Suprathik53/ece445-lab-notebook/notebooks/prineet/README.md

# Prineet Worklog

[[_TOC_]]

# 2026-02-13 - Meeting Zhuchen & Project Proposal

This week marked our first meeting with our group TA, Zhuchen Shao. We told him the idea we had for our project and presented our initial block diagram. This was helpful for both him and us, since in building out our high-level block diagram we were able to better clarify to each other in the group what exactly we meant when we were pitching our idea to each other. 

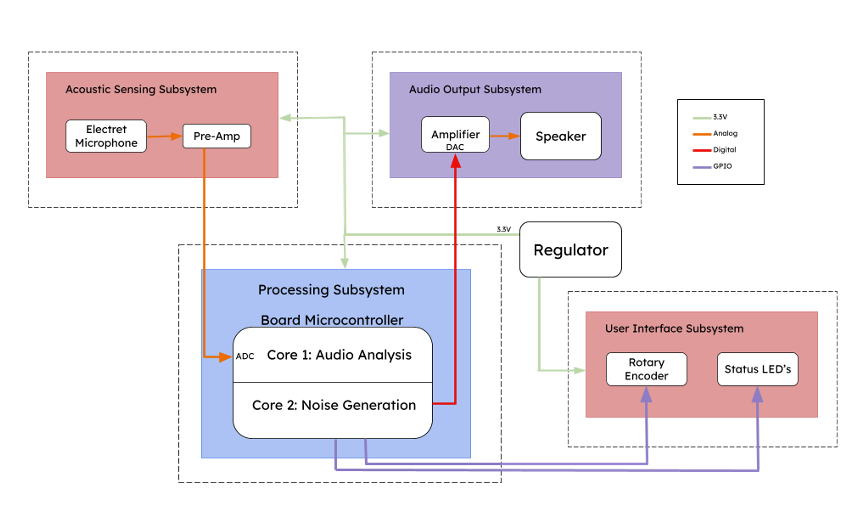
[picture p1: notebooks/prineet/block_diagram.png]


He showed us how we can order our parts in the future and helped us understand more about what was expected of us. I also thought about the PCB and started to draw up plans for what we would want on it when that time would come.

# 2026-02-20 - PCB Schematic is Done

This week, I really worked on hard on making the PCB schematic for the project. I really wanted to make the early deadline of 2/20 to have our PCB reviewed by a TA. I also heard that extra credit was given to teams that were able to do that, but I wasn't able to make the deadline for that. That's ok though, since Supra and Srikar are starting to compile the order list that they want to give to Zhuchen for our first big order of parts. Since I worked on the Schematic, I'll probably let Supra and Srikar take care of the actual layout while I take over for them for ordering the parts and getting ready for our first big lab session. 

I was able to present my schematic to Zhuchen to our group meeting, he seemed impressed and offered me good feedback on what I had done.

This was the processing unit I designed:

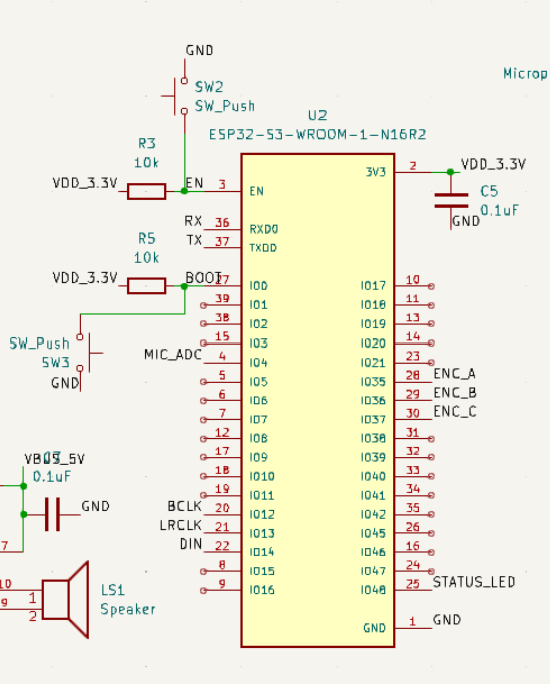
[picture p2: notebooks/prineet/processing_schematic.png]


Here's the microphone/input system:

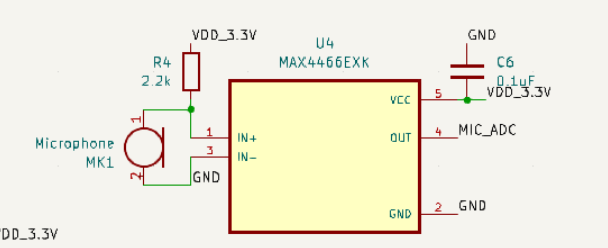
[picture p3: notebooks/prineet/mic_schematic.png]


Finally, here's the speaker schematic:

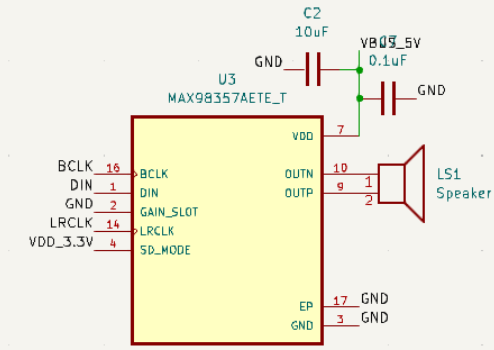
[picture p4: notebooks/prineet/speaker_schematic.png]


# 2026-02-27 - The PCB is Finished

Our group decided to make a couple of core changes to our design. Firstly, we changed to using the Alps Switch encoder for our design. We also changed how we power our whole system. We used to do it with USB-C, that's what I put in the schematic. Howewver, we changed to Micro USB, as it should be easier for us to use and power. The tradeoff with this is that obtaining a Micro USB cable is harder, I know I certainly don't have one. 

Srikar also worked hard this week on the PCB layout. He took the PCB schematic that I made last week, made the proper tweaks to change what I outlined above, and then made the layout for the PCB. 

Here is the finalized PCB layout:

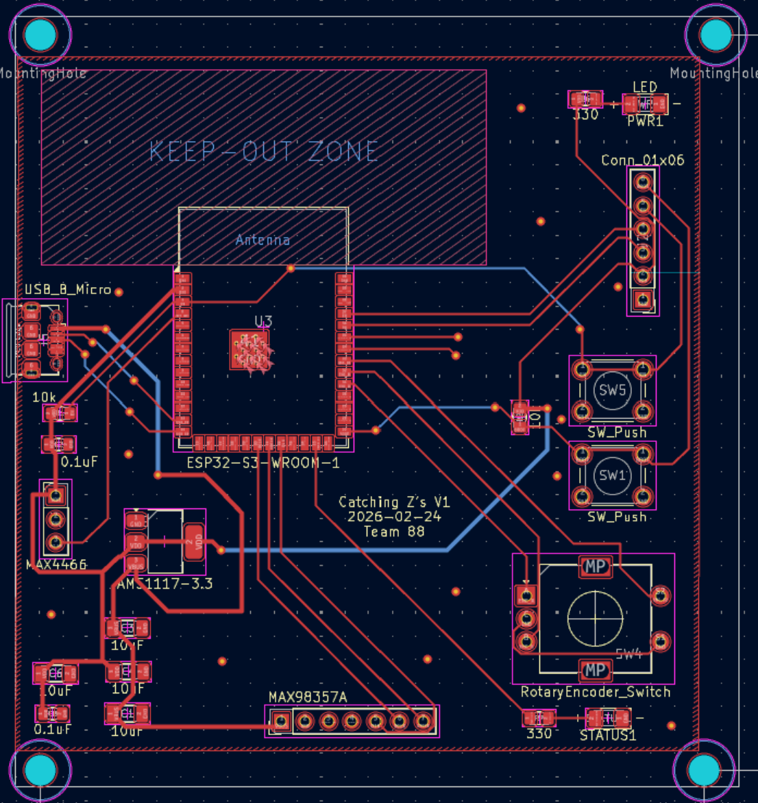
[picture p5: notebooks/prineet/pcb_layout.png]


Me and Supra also worked on updating our order list to account for the changes that we had made to what we need for our PCB. 

I like the current pace of our project. Because we're doing a good job of keeping each other updated, it's made it easier on all of us as it lessens the tension that is associated with having partners during a group project.

Additionally, our design doc was due today. A lot of what we want to accomoplish is in the design doc. I'll attach the relevant portions here.

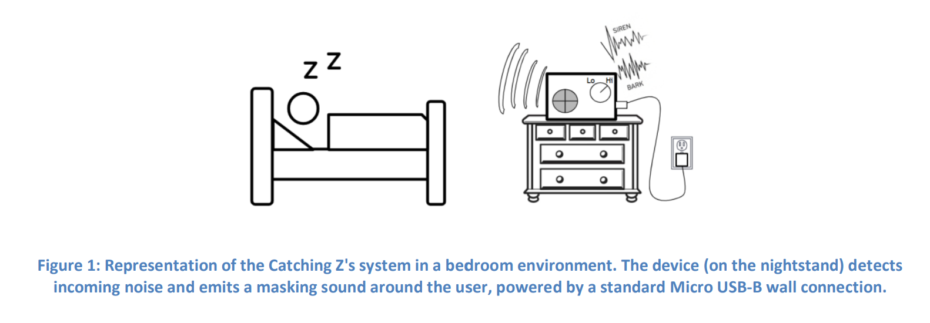
[picture p6: notebooks/prineet/design_doc_1.png]


To trigger a masking noise, the noise event should be at least 10 dB higher than the baseline. So, the amplitude ratio can be found by:

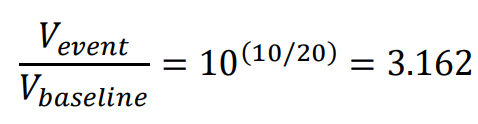
[picture p7: notebooks/prineet/amplitude_ratio.png]


This is what we've estimated our project to cost (this is pretty interesting to me, I wonder how much it would be if we bought the components for this project wholesale, like if we were doing mass manufacturing for this system).

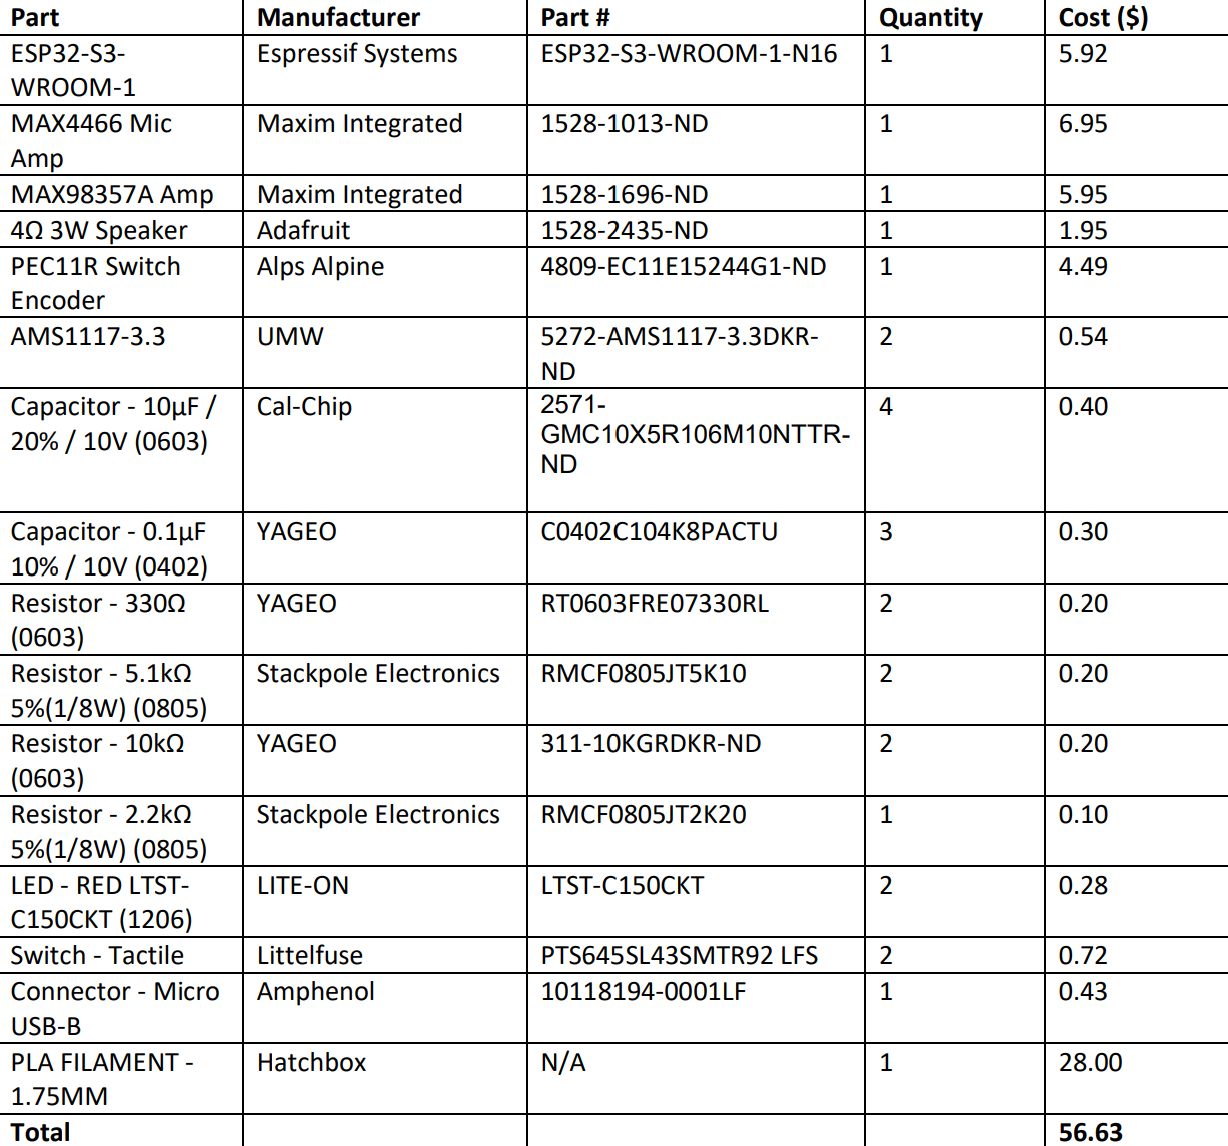
[picture p8: notebooks/prineet/projected_costs.png]


# 2026-03-06 - Prototyping

During our design review with Professor Gruev, he suggested that we make our project more complicated. His main point here is that we were not doing anything novel, which is a fair criticism of our project. We should aim higher, and I believe in our group enough to accomplish it. One of the things that he mentioned was to add spectral analysis to our project. 

With this spectral analysis, we might be able to have the output frequency match the input frequency, allowing for the ability to mask different kind of noises adaptively to what is happening in the background.  

We also started to work on our breadboard. We had to use the ESP32 dev board since our STM32 one didn't work. We added a microphone to get input and a LED array to act as like a volume display to show how loud the input sound was. 

I hope that this is enough progress for our breadboard demo next week. It has been difficult for us since we are still waiting to get some components to start actual dev work, so we had to do the best we could with what we had. I think that what we have right now is sufficient to show that we have a plan with the input audio that comes through the microphone.

# 2026-03-13 - Last Day Before Spring Break

We found some breakout boards that we got permission to use on the final project. This would make the layout of the PCB so much cleaner and smaller, so it was a no brainer for us to use it. Here are the two breakout boards that we found:

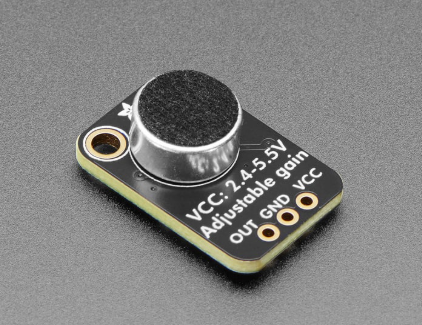
[picture p9: notebooks/prineet/breakout_1.png]


Link: https://www.adafruit.com/product/1063?srsltid=AfmBOoq1_ZeF1upSoV16VT7XkKl8Ah0HNs23jcOlRoFMnywjewPwBUsj 

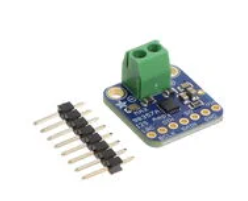
[picture p10: notebooks/prineet/breakout_2.png]


Link: https://www.digikey.com/en/products/detail/adafruit-industries-llc/3006/6058477

We had to update our PCB layout to accomodate for this change. Here is the updated layout:

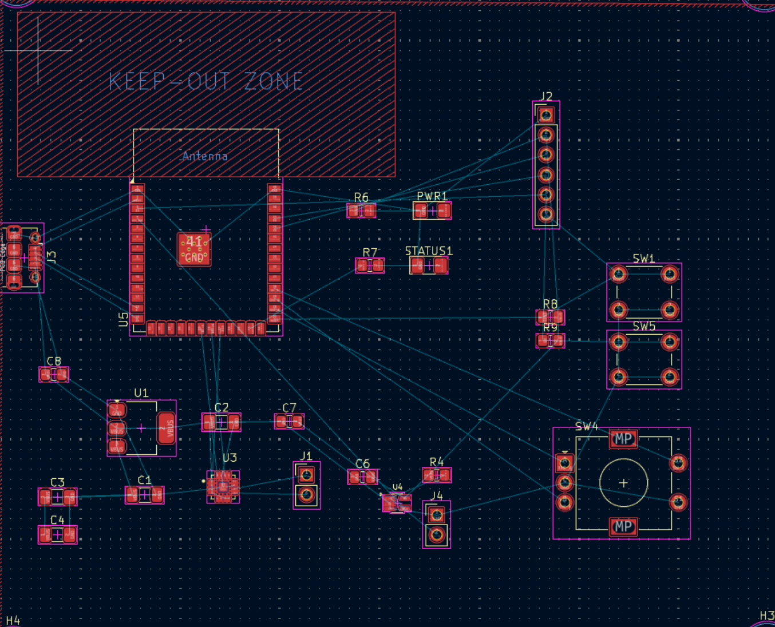
[picture p11: notebooks/prineet/updated_layout.png]


This is what the current state of the breadboard is, with our current hardware on it for the input noise volume sensing:

For our breadboard demo, we were able to integrate the adaptive baseline code. First, the room volume is sampled 100 times, which corresponds to 20 ms. For the final system, we will probably have it sample for a couple of seconds to establish a fimer and prolonged baseline. The current room noise was also sampled as we moved, slowly getting faded into the baseline according to how we tuned an adaptive baseline constant, which we can call alpha. If alpha is high, the current room value plays a big part in updating the moving baseline. If it is low, the change to the moving baseline is more subtle.

The LED is there to simulate the speaker. When the LED turns on, it is as if the threshold has been crossed (which we know due to the tolerance analysis which I included above) and the speaker (in this case, the LED) should be turned on. 

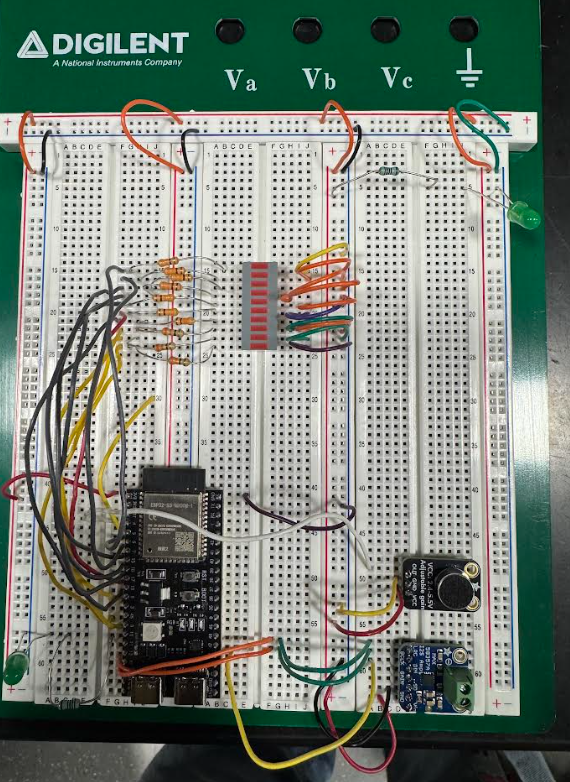
[picture p12: notebooks/prineet/breadboard_demo.png]


# 2026-03-27 - PCB Debugging and Enclosure

We attempted to use our PCB this week. It had its fair share of ups and downs I can talk about. For some reason, when we initially tried to use our PCB the first time, nothing was working. We tried debugging everything, but we couldn't figure out why we couldn't load any code onto the PCB. We even took a knife and cut the PCB down to its traces to make sure that everything was inline with what we thought was going on. We gave up. However, the next day, when we tried a different PCB, everything worked. We were able to solder everything onto that PCB and have the code load into the PCB with no problem. We must have shorted something on the first PCB by soldering incorrectly.

We also submitted a new PCB design that made debugging a little easier, since it was so hard to see what was going wrong on the first PCB that we were using.

Supra also started to design the enclosure in CAD. This would be a 3D model that had mounts for the PCB at the base of the enclosure, the speaker, microphone, and encoder mount. This is the enclosure prototype that Supra came up with:

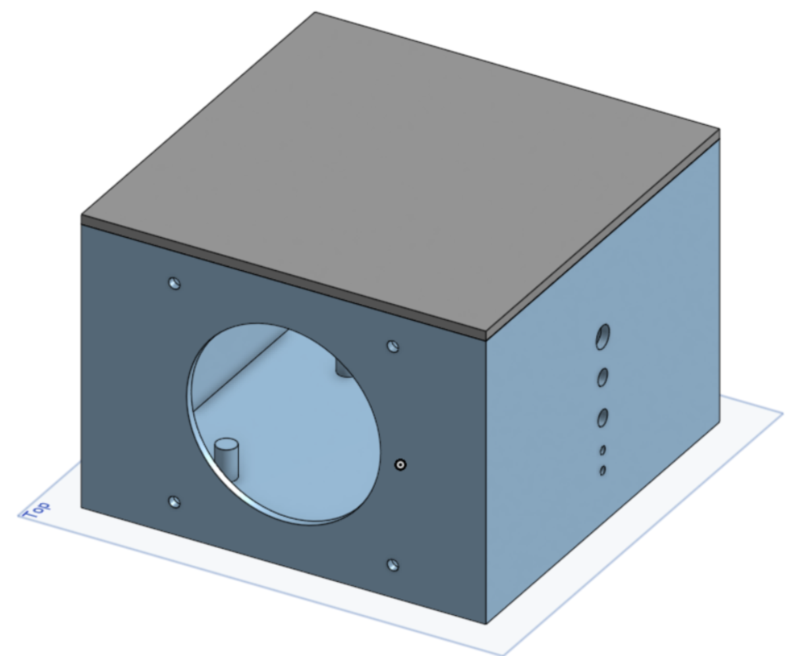
[picture p13: notebooks/prineet/enclosure_1.png]


We also receieved our speakers, so we were able to connnect them to our breadboard and test some code that generated white noise instead of lighting up the LED. That worked, so it was a good sign that we had a good baseline to start from.



# 2026-04-03 - PCB Soldering

We continued to solder the components that we had onto the PCB board, incrementally testing the components that we had soldered with both software and through the oscilloscope. We also transferred the code over from the breadboard to the PCB.

# 2026-04-10 - Coding!

This past week was all about getting as far as we could with the code. The specs that we had in our design doc specified that we would use the two cores that our microcontroller had, one to do input processing and the other to generate the noise. Up till this point, everything had been happening on one core. So, we switched our code to fully utilizing the two different cores. This actually solved an issue we were having, which was with choppy audio. By splitting up the hard work between two cores, each core was able to focus more on doing a better job for the task it was assigned to.

We also added the baseline in for spectral analysis. We did this so that the speaker would play either white, brown, or pink noise depending on what the input frequency was. The output sound fades in and fades out to not create sharp lines that can impact the sleep of the user.

We also did more complex signal analysis on the output besides the spectral analysis. We added a low pass filter to the signal to cut off the errors and reduce any high frequency noise that is not necessary. 

The enclosure also finished printing before our progress demo with Professor Gruev, and we were able to test in the enclosure. We were running into a lot of trouble after putting our system in the enclosure, however, since the microphone and speaker were creating an infinite feedback loop where the speaker output was triggering the microphone input. However, by adding some tissue paper inside the enclosure to act as a dampener, we were able to put a band aid on the problem. In the future, we will need to purchase or find some high quality foam, like the kind that is used in recording studios to block out other noise, and install that along the walls and inside above the PCB and by the inner walls of the speaker and microphone.

# 2026-04-17 - Results + How We Can Make it Better

We have been seeing promising results with everything thusfar. We wanted to expand the directionality that the speakers had so the system could be in different positions and still hit the user as they were speaker. So, we redesigned the system to have two speakers, each outputting the same noise. In order to do this in the hardware, we would change the enclosure to be a pentagon, putting the speakers and microphone on opposite ends to minimize the chance they start an infinite feedback loop. 

During early testing, we found that bucket based spectral analysis did not provide enough variation to generate masking noise that worked well. Because of this, I revised the code so that it reads a 128-sample microphone frame at a 16 kHz sampling rate, subtracts the DC component, calculates loudness-related values, and passes the frame into an analysis routine.

Inside that analysis routine, the signal is first multiplied by a Hann window and then processed with an FFT. For each bin, the magnitude is smoothed across time, and nearby bins are combined to estimate the local energy around that frequency. From there, the program identifies the largest peak and the next-largest peak.

This directly goes into choosing the type of masking sound that we are generating. The program asks whether the frame is loud enough to matter and whether that peak is stronger than the old and secondary peak. If all of these conditions are met, the system will playh the new masking noise to match what it's hearing.

# 2026-04-24 - New Enclosure

The new enclosure finished printing. We trasnferred what we had over to the new enclosure, and using some bolts and nuts that I got from going down to the ECE mechanic shop and trying a bunch of different sized bolts and nuts from different drawers, secured everything in place.

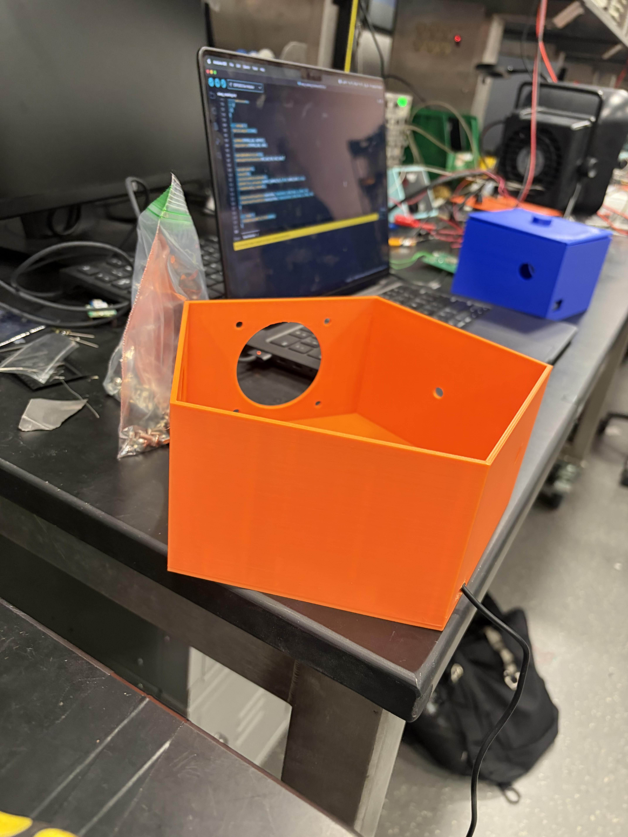
[picture p14: notebooks/prineet/both_enclosures.png]


We also connected the additional speaker by splitting the output wires to the speaker in two, with each set going to a speaker.



After switching to the two speaker approach, we saw that the audio output was extremely choppy. This had something to do with the fact that we had not really tuned our constants for two speakers, so we had to go back to the testing table and continually test our noise until it got better, but the choppiness never really went away. 

We realized that we would have to change to using a lazy buffer. Currently, the processing that we were doing was preventing the ESP from populating the speaker's output buffer at a fast enough rate. So, if we add each generated value to the output buffer more than once, the speaker's output buffer might be able to keep up with the input. This ended up working beautifully.

# 2026-05-01 - Satisfying the Verifications and Python Simulations

Before we were able to get started on the verifications, we had to add the foam into the inside of the enclosure as we said we would to mitigate a feedback loop. We also added another microphone on the inside of the enclosure to subtract what the inside microphone heard from what the speakers were playing to tell the system to not look at that frequency as a potential input. These two fixes worked in tandem to prvent the feedback loop from happening again.

We had to satisfy all the constraints that we set for ourselves when we initially took on this challenge. The most important test was verifying that the system would work overnight (~8 hours) without overheating or breaking. We set the system up overnight and let it work, uninterrupted, while Srikar slept. Here are the logs:

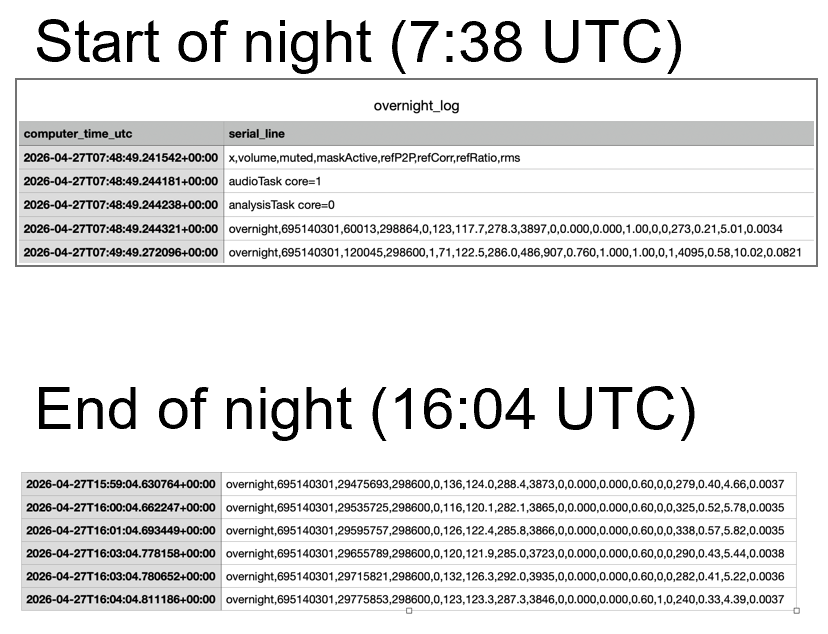
[picture p16: notebooks/prineet/logs.png]


Before our simulations, we could only state qualitatively that by putting your head by the speaker and pretending like you were sleeping, the system would mask the noise that was being played into the microphone. However, the simulation below shows a cool visualization proving the effectiveness of the system.

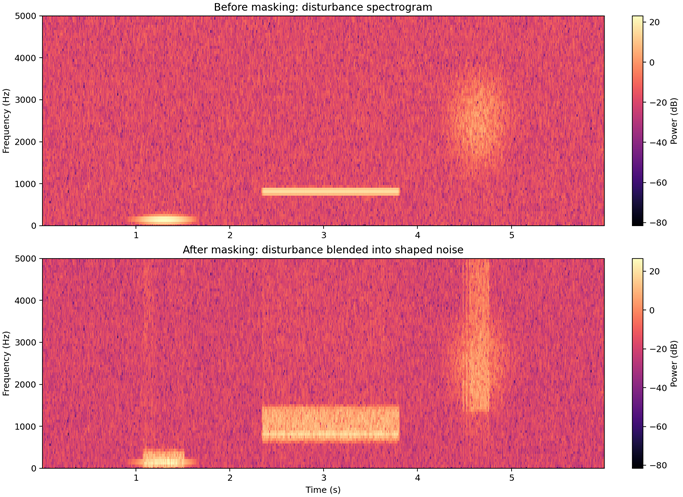
[picture p17: notebooks/prineet/graph.png]


The top plot shows a noise events impact on the event without the noise masking provided by our system. As you can see, the lines are clearly separable, showing a big impact on the user's sleep. The bottom graph, on the other hand, shows what happens when the system is on. The lines are blurred, as the device causes any input noises to fade into the background, severly decreasing the chance that a noise event would disrupt the user's sleep.
