Suprathik53/ece445-lab-notebook/notebooks/suprathik/README.md

# Suprathik Worklog

[[_TOC_]]

# 2026-02-13 - Discussion with TA Zhuchen Shao

This week we first met with our group TA to discuss the overall direction of our project. After building a visual understanding of how the project's subsystems would come together through a block diagram we then finalized logistics on how parts would be ordered and future meeting times and expectations. Later in the week I worked on finalizing the proposal including further ideating on the form factor of the product and deciding the exact sensors and parts we would be using. 



# 2026-02-20 - Schematic Design and Parts Updates

To start this week, our group began developing the schematic for our PCB in KiCad and successfully laid out the components for review during our mentor meeting. After planning part of the PCB design, I worked on preparing an order form for the parts available from the E-Shop.



However, some changes arose while selecting footprints for the schematic components and discussing the rotary encoder we planned to use. We considered adding additional functionality by using a push-button rotary encoder to enable a potential mute feature. As a result, we are currently deciding between a standard rotary encoder for simplicity:

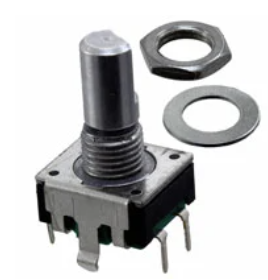
[picture p28: notebooks/suprathik/bourns.png]

[link](https://www.digikey.com/en/products/detail/bourns-inc/PEC11R-4215F-S0024/4499665)

and a push-button encoder for added functionality:

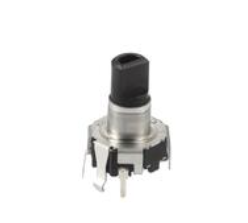
[picture p29: notebooks/suprathik/alps.png]

[link](https://www.digikey.com/en/products/detail/alps-alpine/EC12D1564402/21721641)

We are also deabting switching from the Bourns model proposed earlier to an Alps encoder to better match the available KiCad footprints but will be looking for libraries that include our desired footprints.

# 2026-02-27 - Finalizing PCB Layout and Components

Picking up from last week we decided to switch to using the Alps Switch encoder for our design. After further discussion we also decided to switch from using USB-C to power the device and interface with our micrcontroller to Micro USB. We plan to use this for atleast the first iteration of our PCB as it is easier to hand solder and reduces the complexity for us slightly. After these changes we updated the schematic accordingly. 

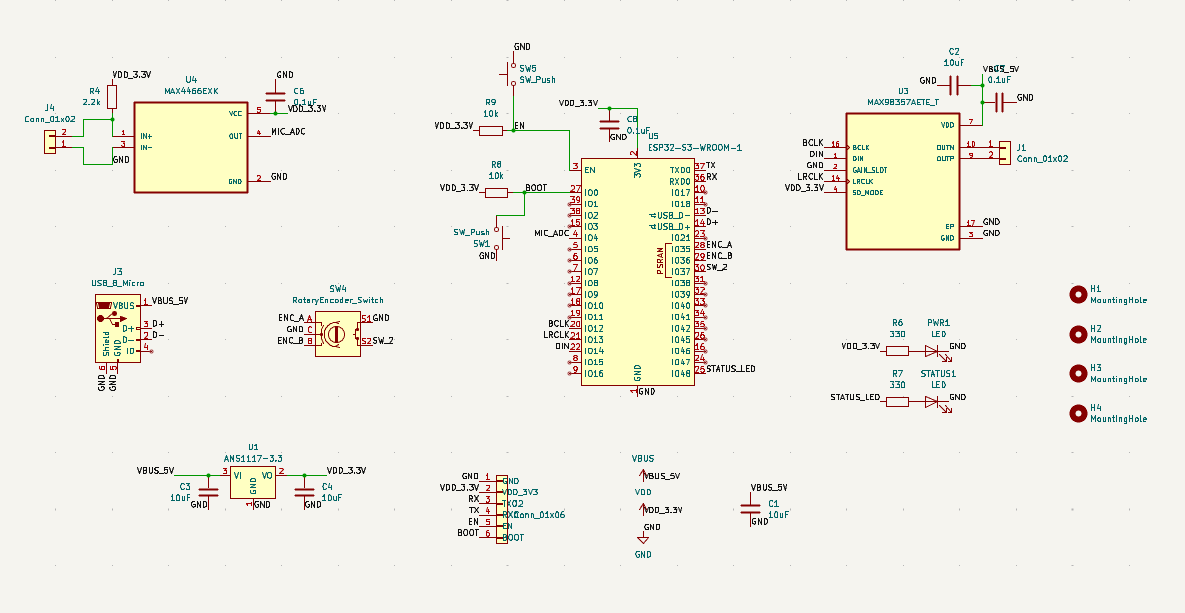
[picture p30: notebooks/suprathik/schematic_2.png]


We then focused on designing the layout of the PCB following similar principles to the CAD assignment and submitted our gerber files after running a DRC and using JLC's DFM verification tool. 

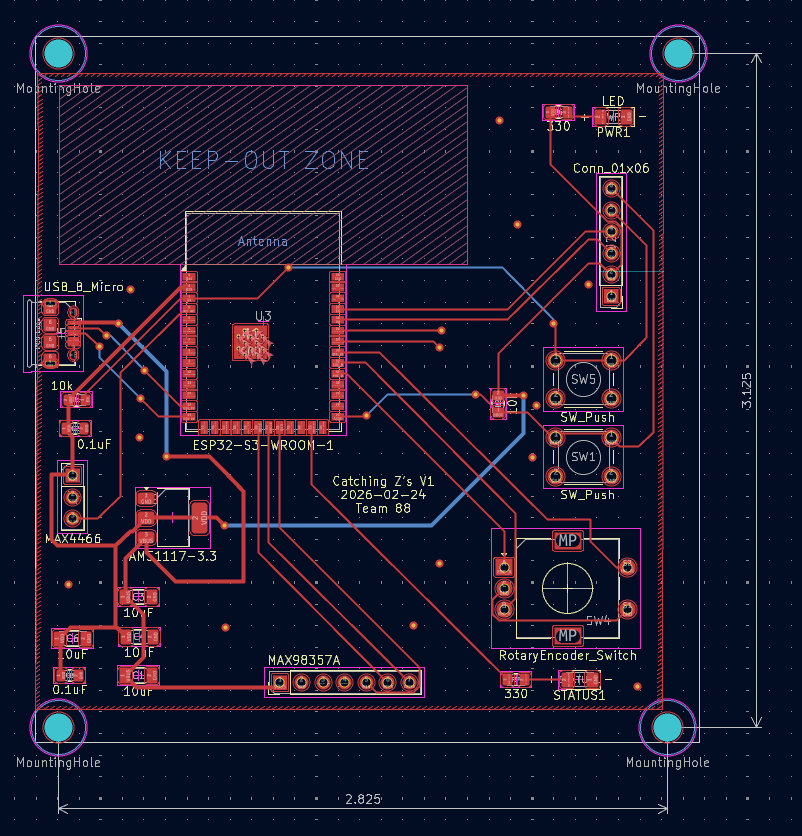
[picture p31: notebooks/suprathik/layout.png]


Finally for ease of testing with development boards we also found breakout boards that implement a lot of the circuitry needed for our audio sensing and audio output subsystems. 


[link](https://www.adafruit.com/product/1063?srsltid=AfmBOoq1_ZeF1upSoV16VT7XkKl8Ah0HNs23jcOlRoFMnywjewPwBUsj)


[link](https://www.digikey.com/en/products/detail/adafruit-industries-llc/3006/6058477)

# 2026-03-6 - Breadboard Development and PCB Updates

After presenting our design document during our design review we had some new ideas and modifications we wanted to add to our project. One of the ideas we had was adding a spectral analysis component to our software. This addition would allow us to distinguish between distinct sounds such as dog barks or footsteps and then generate the corresponding masking noise for that situation. We would use some prebuilt FFT libraries and after collecting the data run some sort of classifaction:

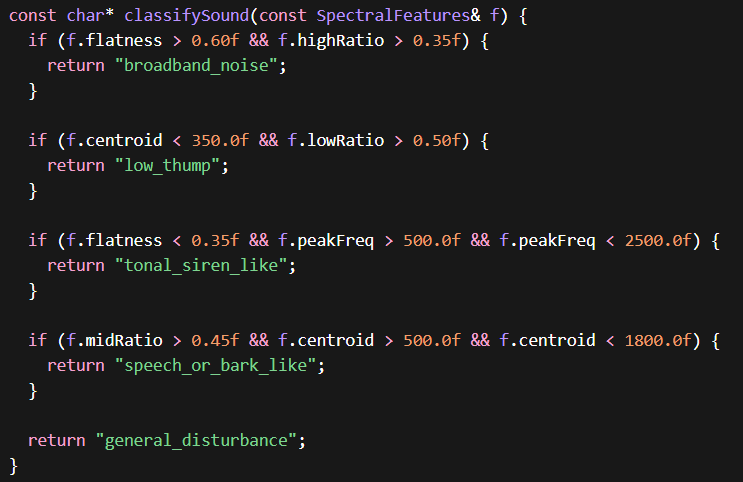
[picture p32: notebooks/suprathik/classification.png]


Further we made some updates to our PCB to accomadate our own implementation of the speaker and microphone breakout boards and plan to finish up the layout in order to submit for a PCB order. We plan on finishing the following layout:

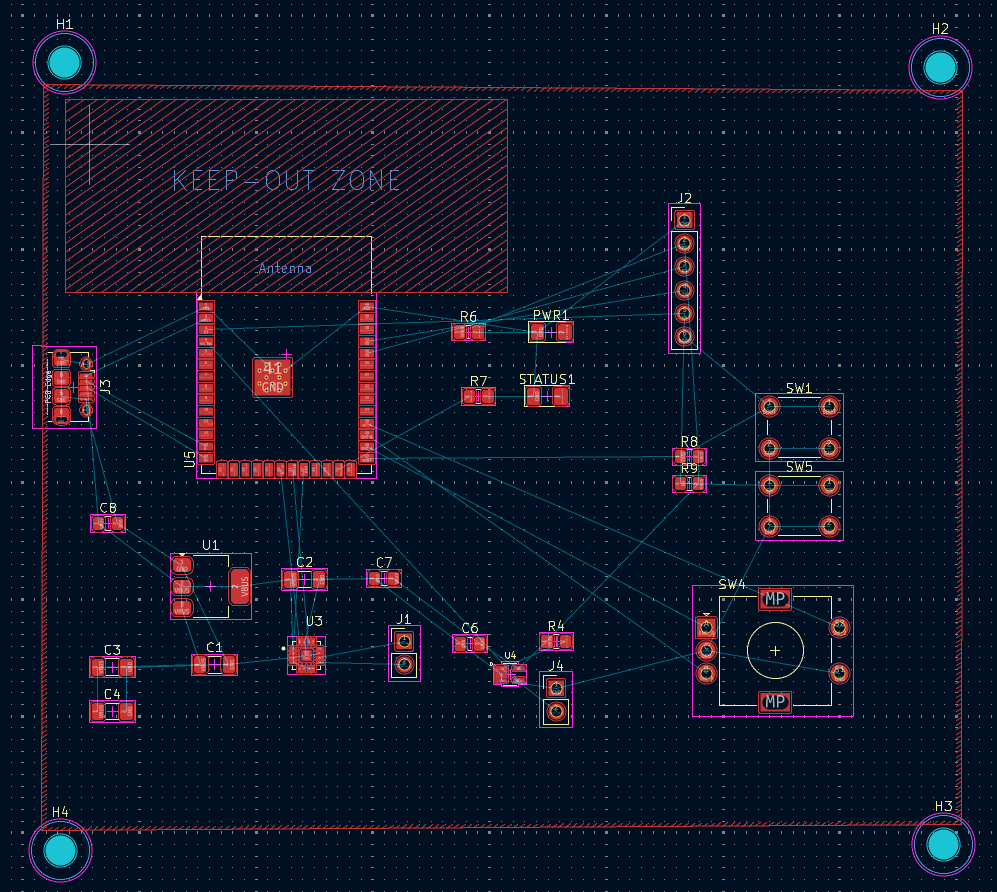
[picture p33: notebooks/suprathik/wip_layout.png]


# 2026-03-13 - Further Work on Breadboard

After receieving more components including our electret microphone we began working on our breadboard prototype for our project. For this demo we focused on setting up sound detection and worked on providing visual feedback of the picked up sound through LED's. We then worked with tweaking the code as well as the gain in order to eventually reach a spot where we were getting stable readings for the ADC accoriding to the values we had gotten from our tolerance analysis:

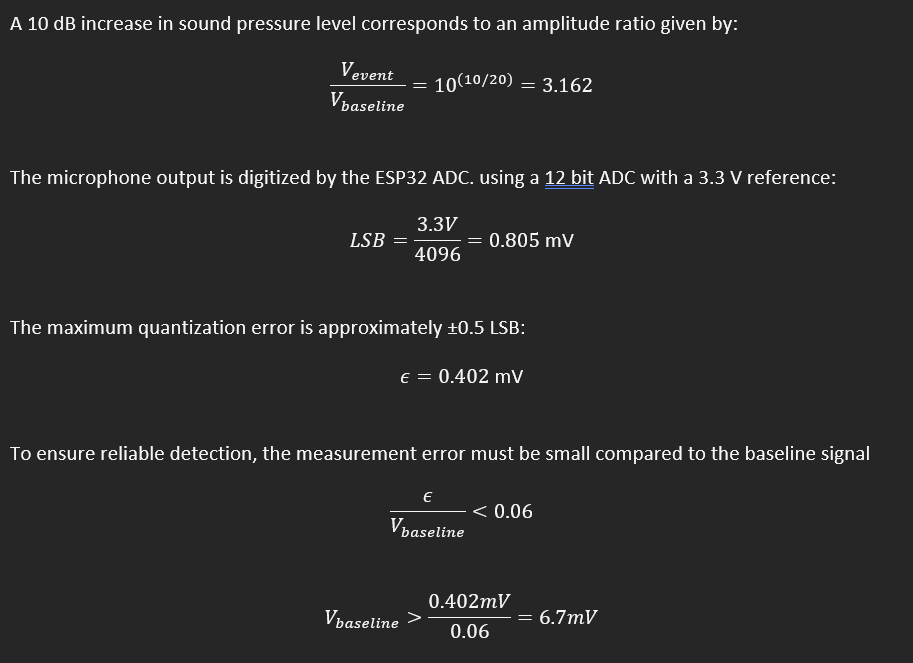
[picture p34: notebooks/suprathik/tolerance.png]


Once we got the hardware setup we then built on our software including creating an adaptive noise baseline that monitors the surrounding and continually updates what the base volume is. 



 Once we had that finalized we also decided to simulate audio generation with an LED as a placeholder for the speaker. This LED would fade in and out based on our spike detection algorithm which played audio when spikes 10 decibels above the baseline were picked up. 

# 2026-03-27 - Enclosure CAD and Speaker Testing

For this week our goals revolved around designing a 3d model for our project enclosure, integrating the speaker with our breadboard demo, and soldering components onto our PCB. 

Since we are planning to 3d print an eclosure for our project I spent some time creating a mock prototype design for initial testing of our circuit in OnShape. This is initial design will give us an idea of any interference that may occur between our speaker and microphone and help us better position them for the final iteration:

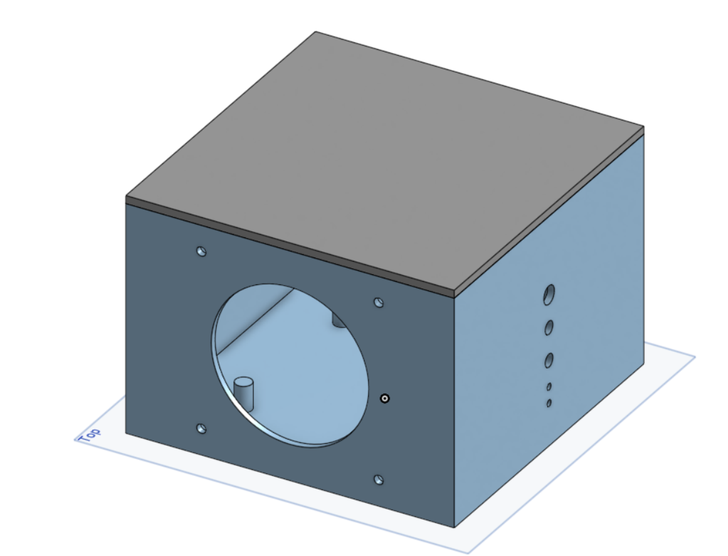
[picture p35: notebooks/suprathik/enclosure_proto.png]


Furthermore, since we received our PCB's and speaker we were then able to begin development using those parts. We were able to integrate the speaker where we previously had our placeholder LED in our breadboard demo and tested some code that generated white noise to be played when triggers were identified. Finally we worked on soldering our microntroller and microphone on to our PCB in order to verify the PCB's functionality.

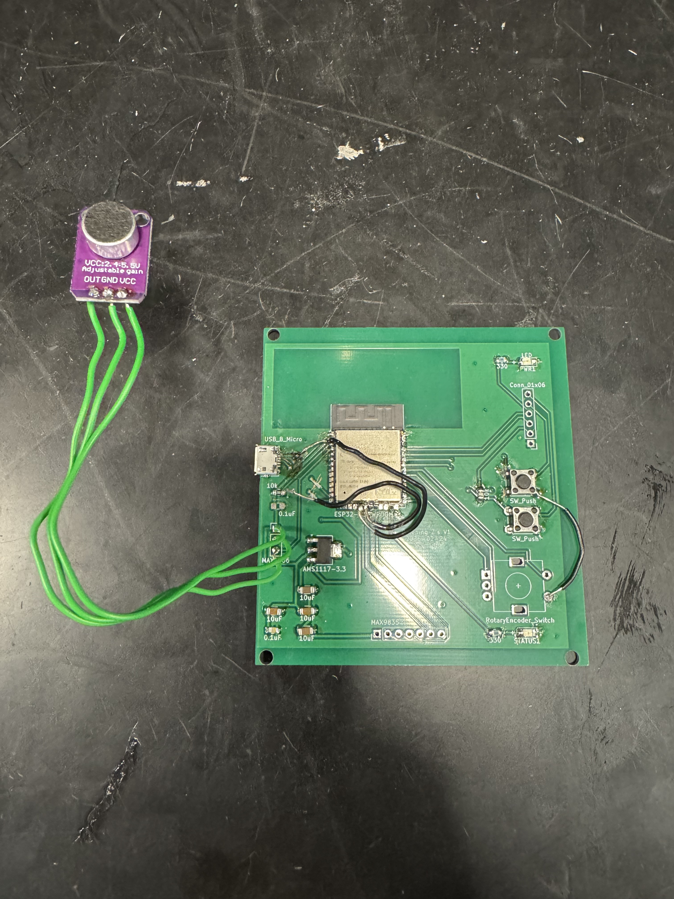
[picture p36: notebooks/suprathik/PCB_V1.jpg]


# 2026-04-03 - Setting up New PCB & Finishing CAD Prototype

Picking up where we left off last week we began soldering some new parts we received from the E-shop in order to begin deploying code to our microcontroller. However, once we soldered on the necessary pieces for testing our subsytems we ran in to issues with certain pins for our switches not being grounded and the datalines not functioning properly. Luckily, our version 2 boards arrived quickly after and once we had the subsytems in place on that board everything worked according to how we expected. We then worked on transferring the code and functions we had on our breadboard to the PCB iteration and experimented more with the limits of our speaker modifying the sensitivity from a baseline of 500 through 5000. 

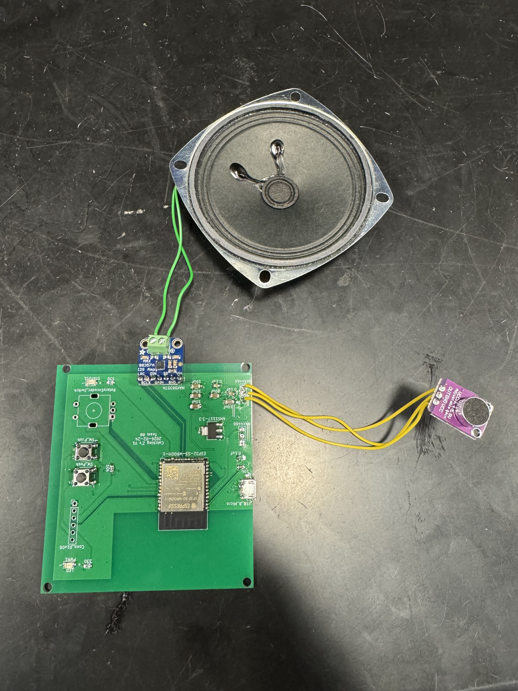
[picture p37: notebooks/suprathik/PCB_v2.jpg]


Further, I continued to work on the CAD for our initial design and am preparing to print in the upcoming week using Bambu Studio. This will set us up to begin testing our project in different environments. 

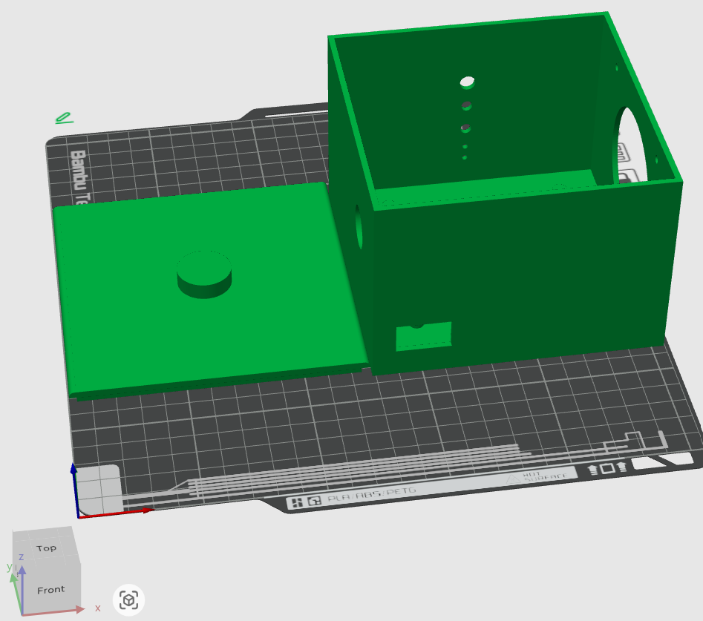
[picture p38: notebooks/suprathik/bambu.png]


# 2026-04-10 - Audio Output Smoothing & Enclosure Testing

Now that we had our components soldered to the PCB and functioning we then worked on implementing our desired funcitonality through code. We worked on utilizing the dual cores on the microcontroller to ensure enough CPU compute for smooth audio output on the microcontroller. To further improve the output quality we added a low pass filter to smooth the signal and reduce high frequency noise that can make the audio sound harsh. We used a second-order digital biquad filter:

$$
H(z) = \frac{b_0 + b_1 z^{-1} + b_2 z^{-2}}{1 + a_1 z^{-1} + a_2 z^{-2}}
$$

which follows the difference equation:

$$
y[n] = b_0 x[n] + b_1 x[n-1] + b_2 x[n-2] - a_1 y[n-1] - a_2 y[n-2]
$$

The coefficients are computed from the cutoff frequency $f_c$, quality factor $Q$, and sampling rate $f_s$:

$$
\omega = \frac{2\pi f_c}{f_s}, \quad \alpha = \frac{\sin(\omega)}{2Q}
$$

Applying this filter reduces the high frequency components and results in a smoother more natural audio output.

We then further worked on implementing logic to prevent feedback loops between the microphone and speaker. We also worked on implementing spectral analysis to detect specific frequency bins to play brown, pink, and white noise at <300Hz, between 300Hz and 1500Hz, and >1500Hz respectively. 

Finally we also finished 3D printing the intial prototype of our enclosure to test our microphone and speaker placement and test its acoustics. We now have plans to order foam and better position the screw holes for the components to minimize vibrations for our next print. 

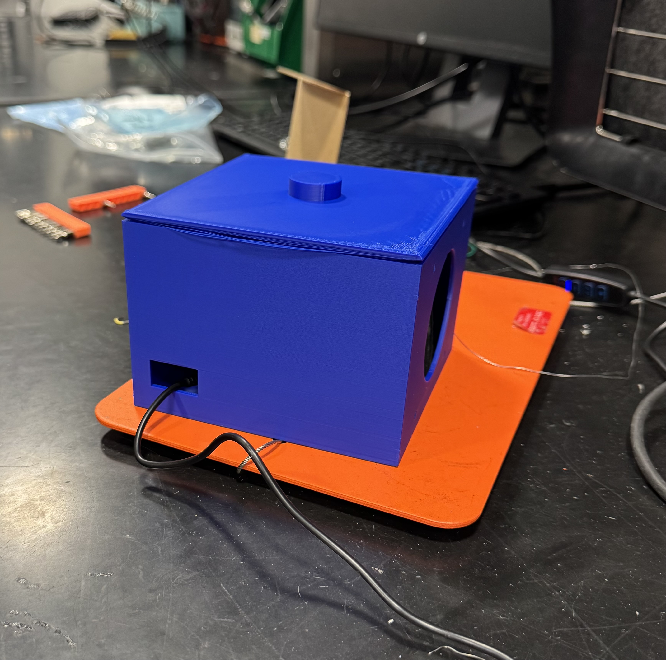
[picture p39: notebooks/suprathik/enclosure_print.jpg]


# 2026-04-17 - New Enclosure Design & Spectral Analysis Implementation

When testing with our new prototype we realized that while the speaker proved effective in overwhelming the frequency bins of distrubing audio when listened to in the direction it was oriented, the audio output was underwhelming in other directions. As such, to hit a wider range with the generated audio we decided to modify our design to utilize two speakers driven from the same pins. This would allow us to not only hit a wider range directly but also increase the volume we are able to output. Further, we modifed the box design to a pentagon shape in order to maintain decent distance between the speakers and the microphone to prevent any interference and feedback loops. We plan to begin printing the following week. 

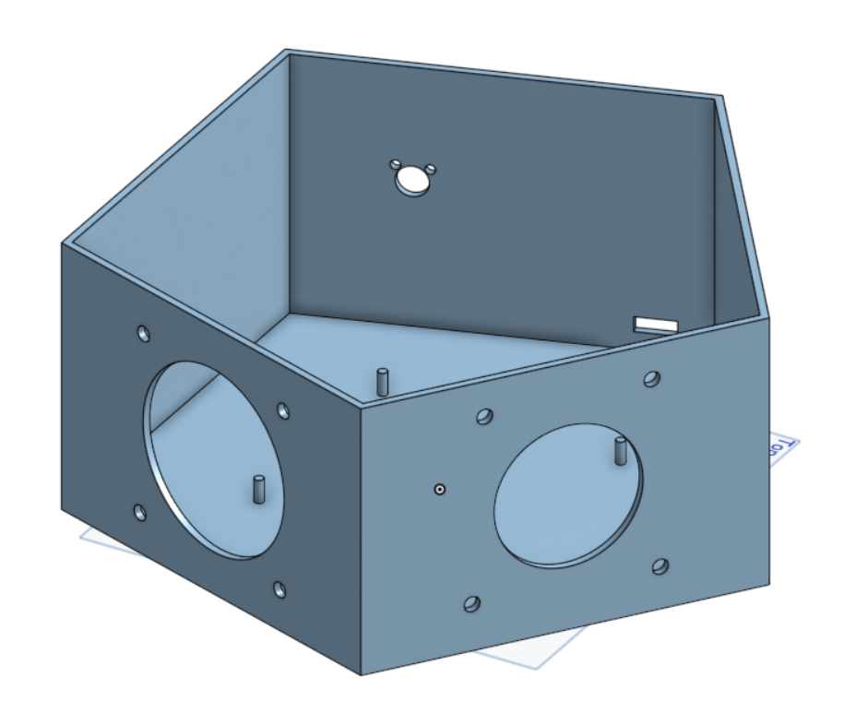
[picture p40: notebooks/suprathik/pentagon.png]


On the software side we continued to implement a more advanced version of spectral analysis compared to the simple 3 frequency bins we were using previously. Our new approach utilizes FFT's to more accurately categorize incoming audio events and then overwhelm more precise frequency bins to better target the disturbance. We achieved precise frequency bin detection through the use of a hanning window to reduce spectral leakage by implementing the following formula in our analysis: gAnalysisWindow[i] = 0.5 - 0.5*cos(...).  

# 2026-04-24 - Pentagon Enclosure Implementation

This week we mainly worked on further refining the software to minimize feedback loops in our rectangular enclosure design. We tested different materials for noise dampening including tissues, bubble wrap, and foam. Through testing these materials we finally arrived at foam as having the most consistent success at the different frequency ranges we tested with(400Hz - 2kHz). 

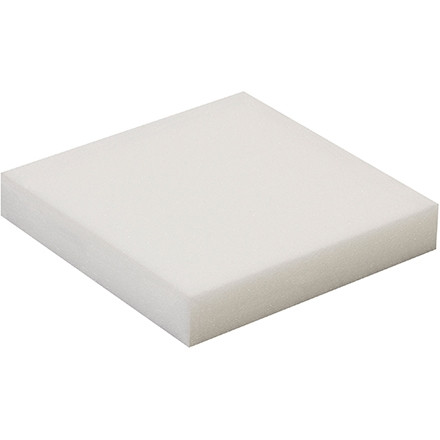
[picture p41: notebooks/suprathik/foam.jpg]


We further worked on improving the audio quality to prevent a choppy output. In order to achieve this we implementented a lazy buffer. We realized that the processing we needed to do on the backend prevented the ESP from populating the speaker's output buffer at a fast enough rate. We then mitigated this by adding each generated value to the buffer twice. This ensured smooth output while still keeping the audio generation adaptive. 

Finally, we fully printed the new pentagon eclosure and transferred our components to begin testing with it.

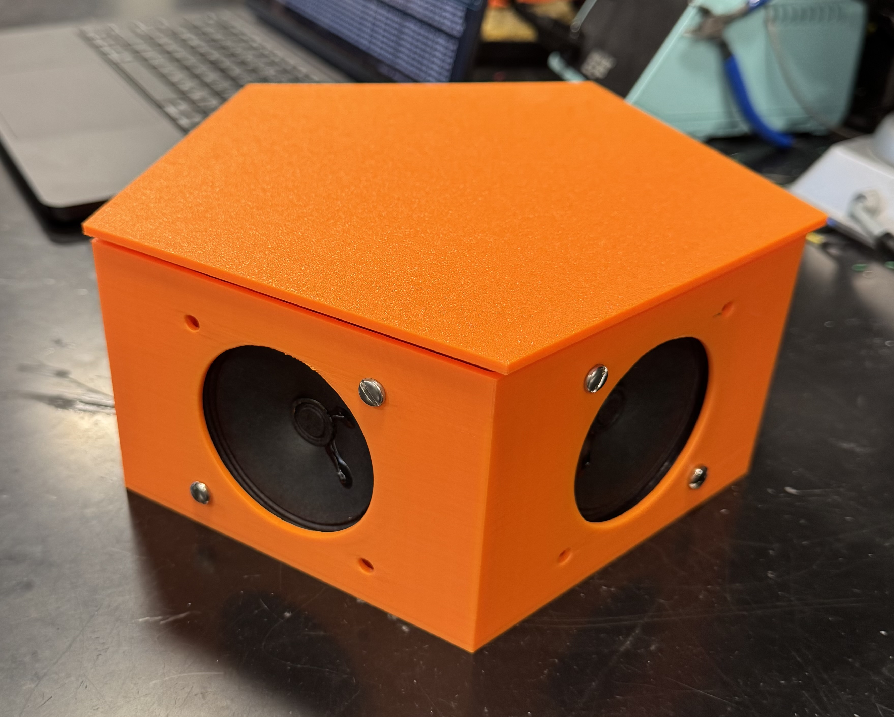
[picture p42: notebooks/suprathik/pent_enc.jpg]


# 2026-05-01 - Visualizations & Verifications

This week when testing the new enclosure in a louder environment we noticed some issues with the feedback loop once again despite isolating the microphone utilizing the foam we tested the previous week. As such we implemented a hardware solution utilizing the second mic we added to our PCB. We position the second microphone next to our speakers to pick up their output. We then subtracted the reference mic's reading from the main mic to get the actual encironment noise according to the following formula: cleaned = mic - gain * refMic. This provied effective in our tests in both loud environemtns(60dB) and quiet rooms(30dB). 

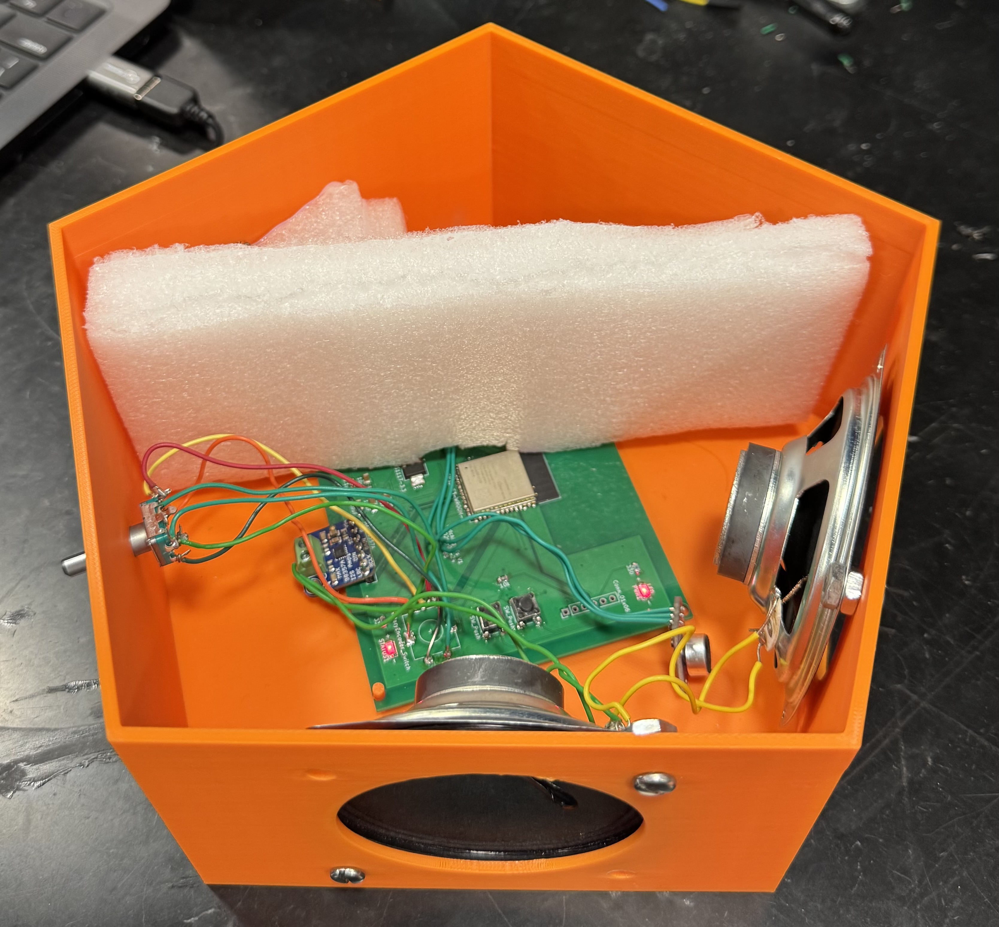
[picture p43: notebooks/suprathik/foam_add.jpg]


We then worked through having more visual feedback of our system functioning through generating a waveform of our systems's baseline, input readings, and output Hz. These would signal if the system is effectively adapting to the room and any distrurbance with the matching output frequency. 

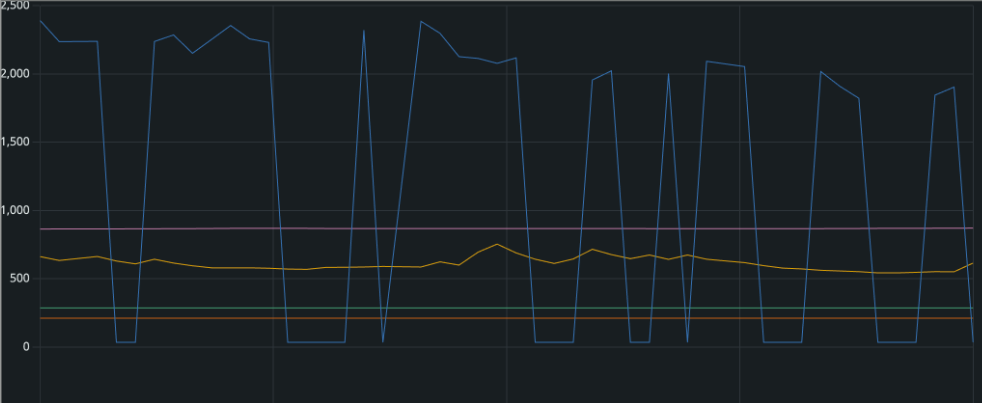
[picture p44: notebooks/suprathik/waveform.png]


Then we verified with requirements we set by measuring the dB level at a distance of 0.5 meteres, added latency checks for the system from detecting a disturbance to outputing sound, and verified our 16kHz sampling rate through checking if our sampling buffer of size 256 populated with 16ms. These ensured that our product was fully functional.
