Suprathik53/ece445-lab-notebook/(commit log)

2026-02-20 Update date in README for schematic design section
2026-03-13 last notebook commit before spring break
2026-03-23 week before spring
2026-05-01 updating notebook and adding code
    [overnight_log.csv]
