Suprathik53/ece445-lab-notebook/notebooks/srikar/foam.png

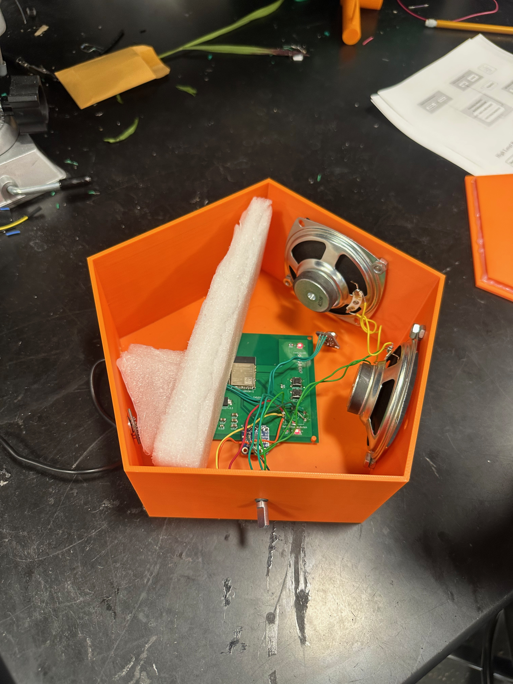
[picture p23: notebooks/srikar/foam.png]
notebooks/srikar/foam.png
