Suprathik53/ece445-lab-notebook/notebooks/srikar/device_with_graph.png

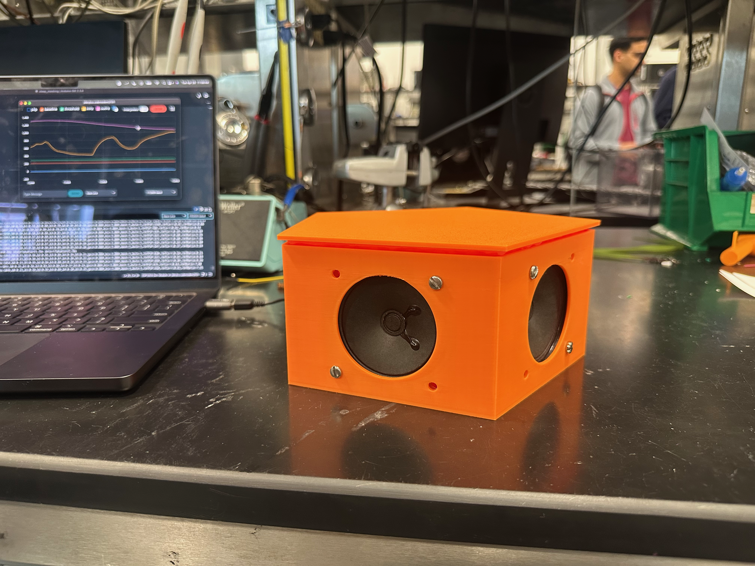
[picture p27: notebooks/srikar/device_with_graph.png]
notebooks/srikar/device_with_graph.png
