Suprathik53/ece445-lab-notebook/notebooks/prineet/both_speakers.png

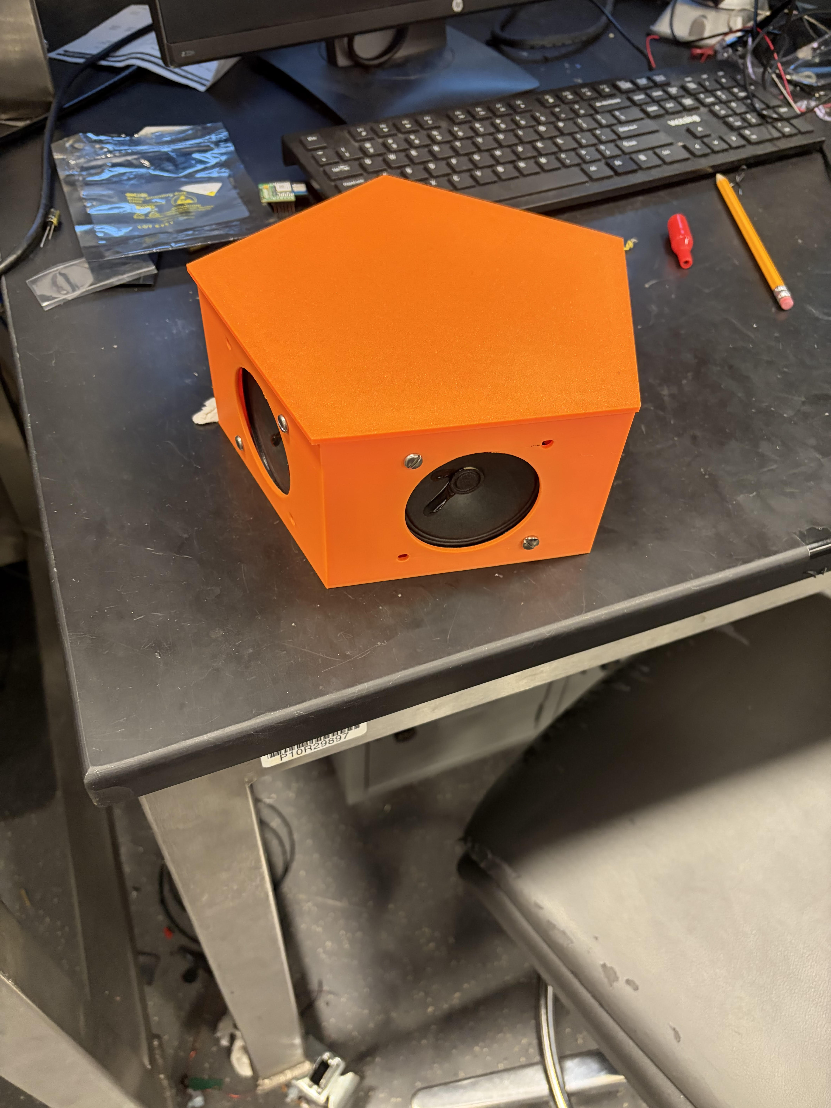
[picture p15: notebooks/prineet/both_speakers.png]
notebooks/prineet/both_speakers.png
